obono/ATtiny85RpnCalc/README.md

# ATtiny85RpnCalc

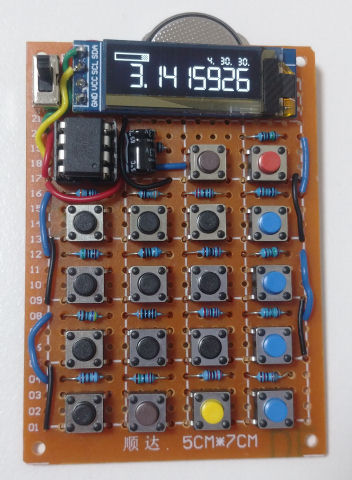
[picture p1: doc/picture.jpg]
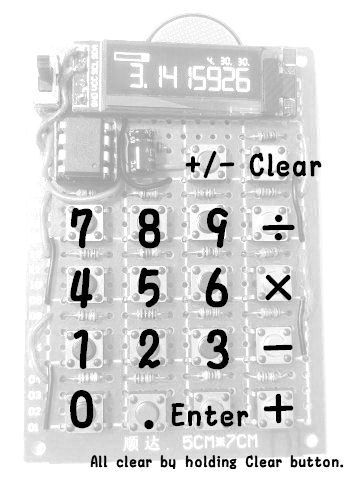
[picture p2: doc/picture_key_assign.jpg]
Key assign


A RPN Calculator with ATtiny85.

* 8 significant digits.
* 16 Levels stack with overflow prevention.

## Instruction

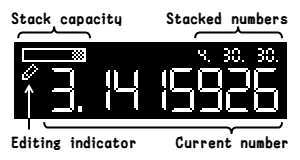
[picture p3: doc/instruction.png]
Instruction


* 0~9, ., &plus;/&minus;
  * Edit the current number.
  * If it is determined, it's pushed into the stack and a new number is edited.
* Enter
  * Determine the current number.
  * If it is already determined, it's duplicated and pushed into the stack.
* &plus;, &minus;, &times;, &div;
  * Pop a number from the stack and operate with the current number.
* Clear
  * Clear the current number and pop a number from the stack.
  * All clear if this button is held long.

## Hardware

### Components

* ATtiny85
* 0.91 inch 128&times;32 pixels OLED screen SSD1306 I2C
* 18 tactile switches
* Resistors
  * 150&Omega;, 180&Omega;, 220&Omega;, 330&Omega;, 390&Omega;, 510&Omega;, 680&Omega;
  * 1.0k&Omega;, 1.5k&Omega;&times;2, 2.2k&Omega;, 3.0k&Omega;, 4.7k&Omega;&times;2, 8.2k&Omega;
  * 15k&Omega;, 22k&Omega;, 82k&Omega;
* An electrolytic capacitor: 47&micro;F
* A battery holder for CR2032
* A slide switch
* Wires, connectors, etc...

### Schematic

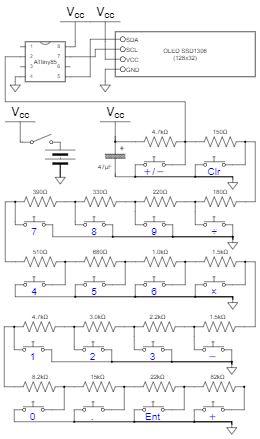
[picture p4: doc/schematic_thumbnail.png]
Click to expand


## Software

### Build environment

[Install ATTinyCore boards to the Arduino IDE](https://github.com/SpenceKonde/ATTinyCore/blob/master/Installation.md) and configure the settings as follows.

Attribute        |Value
-----------------|------------------------------
Board            |ATtiny25/45/85 (No bootloader)
Chip             |ATtiny85
Clock            |4 MHz (Internal)
B.O.D. Level     |B.O.D. Disabled (saves power)
Save EEPROM      |EEPROM not retained
Timer 1 Clock    |CPU (CPU frequency)
LTO              |Enabled
millis()/micros()|Disabled

### Acknowledgement

* [SimpleWire.h](https://lab.sasapea.mydns.jp/2020/03/11/avr-i2c-2/)
  * Copyright (c) 2020 Sasapea's Lab. All right reserved.

### License

These codes are licensed under [MIT License](LICENSE).

## References

* [nekopla/simple_rpn_calc](https://github.com/nekopla/simple_rpn_calc)
* [pado3/tinyRPN](https://github.com/pado3/tinyRPN)
