obono/ATtiny85RpnCalc/doc/schematic.png

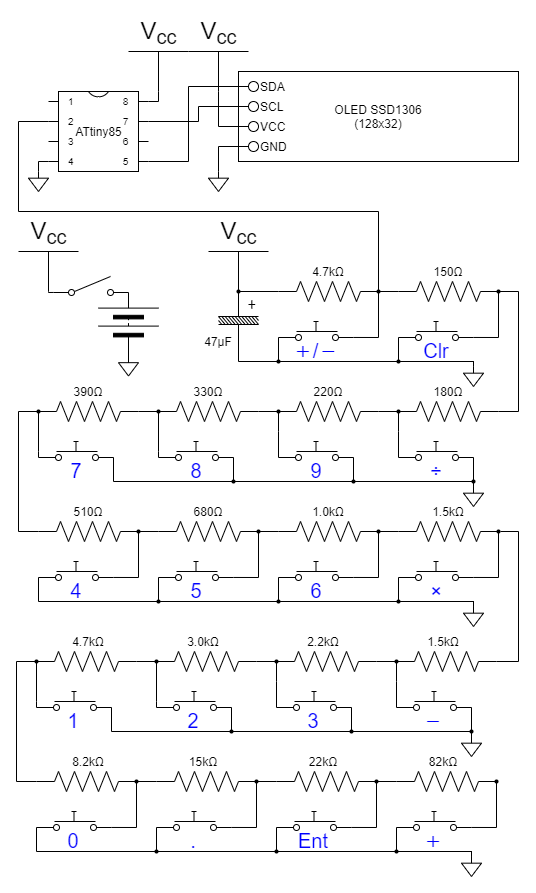
doc/schematic.png
