obono/ATtiny85RpnCalc/data.h

#pragma once

enum : uint8_t {
    IMG_ID_0 = 0,
    IMG_ID_1,
    IMG_ID_2,
    IMG_ID_3,
    IMG_ID_4,
    IMG_ID_5,
    IMG_ID_6,
    IMG_ID_7,
    IMG_ID_8,
    IMG_ID_9,
    IMG_ID_BAR,
    IMG_ID_E,
    IMG_ID_DOT,
    IMG_ID_MAX
};

#define IMG_DIGIT_W 12
#define IMG_DIGIT_H 24
#define IMG_DOT_W   2
#define IMG_PADDING 2

PROGMEM static const uint8_t imgDigit[][36] = { // 12x24 x13
    {
        0xF8, 0xF4, 0x0C, 0x0C, 0x0C, 0x0C, 0x0C, 0x0C, 0x0C, 0x0C, 0xF4, 0xF8,
        0xDF, 0x8F, 0x00, 0x00, 0x00, 0x00, 0x00, 0x00, 0x00, 0x00, 0xC7, 0xEF,
        0x7F, 0xBF, 0xC0, 0xC0, 0xC0, 0xC0, 0xC0, 0xC0, 0xC0, 0xC0, 0xBF, 0x7F // '0'
    },{
        0x00, 0x00, 0x00, 0x00, 0x00, 0x00, 0x00, 0x00, 0x00, 0x00, 0xF0, 0xF8,
        0x00, 0x00, 0x00, 0x00, 0x00, 0x00, 0x00, 0x00, 0x00, 0x00, 0xC7, 0xEF,
        0x00, 0x00, 0x00, 0x00, 0x00, 0x00, 0x00, 0x00, 0x00, 0x00, 0x3F, 0x7F // '1'
    },{
        0x00, 0x04, 0x0C, 0x0C, 0x0C, 0x0C, 0x0C, 0x0C, 0x0C, 0x0C, 0xF4, 0xF8,
        0xC0, 0xA0, 0x30, 0x30, 0x30, 0x30, 0x30, 0x30, 0x30, 0x30, 0x17, 0x0F,
        0x7F, 0xBF, 0xC0, 0xC0, 0xC0, 0xC0, 0xC0, 0xC0, 0xC0, 0xC0, 0x80, 0x00 // '2'
    },{
        0x00, 0x04, 0x0C, 0x0C, 0x0C, 0x0C, 0x0C, 0x0C, 0x0C, 0x0C, 0xF4, 0xF8,
        0x00, 0x20, 0x30, 0x30, 0x30, 0x30, 0x30, 0x30, 0x30, 0x30, 0xD7, 0xEF,
        0x00, 0x80, 0xC0, 0xC0, 0xC0, 0xC0, 0xC0, 0xC0, 0xC0, 0xC0, 0xBF, 0x7F // '3'
    },{
        0xF8, 0xF0, 0x00, 0x00, 0x00, 0x00, 0x00, 0x00, 0x00, 0x00, 0xF0, 0xF8,
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
    { 0x00, 0x08, 0x08, 0x00 }, // '-'
    { 0x36, 0x49, 0x49, 0x00 }, // 'E'
    { 0x40, 0x00, 0x00, 0x00 }  // '.'
};

#define IMG_ENTERING_W  8
#define IMG_ENTERING_H  8

PROGMEM static const uint8_t imgEntering[8] = { // 8x8
    0xE0, 0x90, 0xA8, 0x44, 0x22, 0x11, 0x0A, 0x04
};
