obono/ATtiny85RpnCalc/(commit log)

2021-08-13 :sparkles: Improve arithmetic capacity
    * Number of significant digits is 8
    * Levels of stack is 16
    * Larger glyphs
    * Display stacked numbers and indicator
2021-08-14 :+1: Tiny tuning
    * 'Clear' and 'All clear' functions
    * Display the indicator of entering
    * Regard a too small number as 0
    [calc.cpp, common.h, core.cpp, data.h]
2021-09-19 :bug: Bug fix: the case of entering negative value
    [calc.cpp, common.h, core.cpp]
